soulscircuit/pilet/README.md

# pilet
this repository contains 3d files, pcb files, schematics, and documentation for pilet mini-computer. 
all files will be gradually released here. The schematics and pcbs are designed in kicad and released under CERN-OHL-P license. 

# current releases
- nvme module
