soulscircuit/pilet/nvme-module/README.md

#  License
The hardware design files for the Pilet PCB are licensed under the [CERN Open Hardware License v2 - Permissive (CERN-OHL-P-2.0)](https://ohwr.org/project/cernohl).

You are free to use, modify, manufacture, and sell the hardware, provided that:
- You include attribution to the original author Soulscircuit.com
- You include a copy of this license in your distribution
