soulscircuit/pilet/nvme-module/components/0518CDMCCDS-2R2MC/3D/0518CDMCCDS-2R2MC.stp

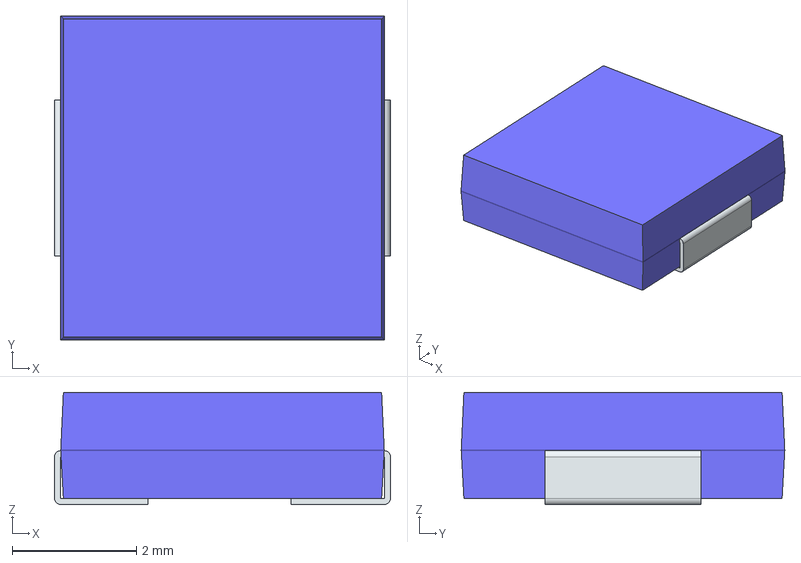
[picture p1: CAD file, 2025-11-07]
nvme-module/components/0518CDMCCDS-2R2MC/3D/0518CDMCCDS-2R2MC.stp
5.40 x 5.20 x 1.80 mm
FilletPin1
FilletPin2
