soulscircuit/pilet/nvme-module/components/687316124422/6873XX124422_687316124422.step

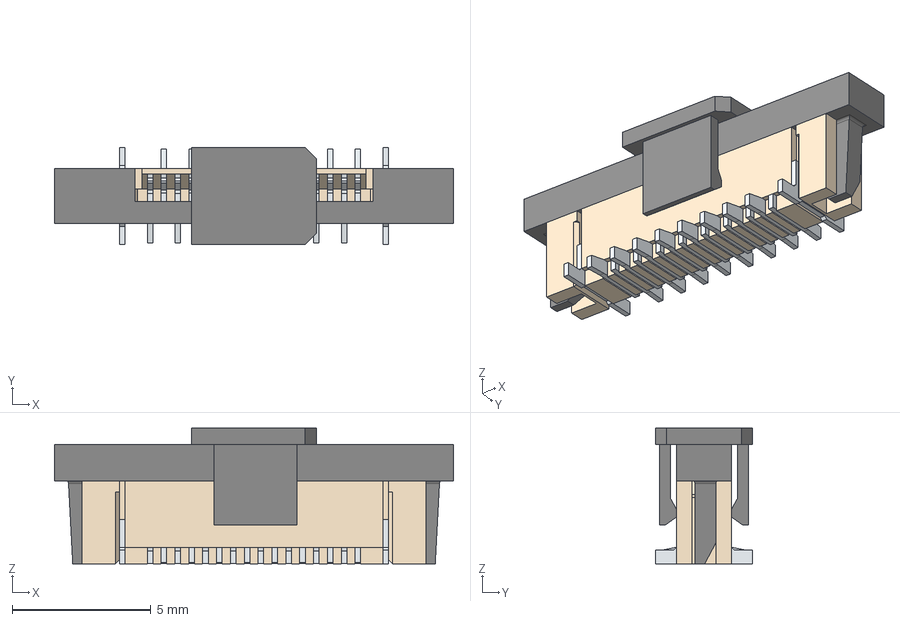
[picture p2: CAD file, 2025-11-07]
nvme-module/components/687316124422/6873XX124422_687316124422.step
14.4 x 3.50 x 4.90 mm
6873xx124422_PIN_COTE x 2
6873xx124422_PIN_A x 8
6873xx124422_PIN_B x 8
6873xx124422_Pick and Place
687316124422_CAP
