soulscircuit/pilet/nvme-module/components/ASEK-32.768KHZ-LRT/OSC-SMD_4P-L3.2-W2.5-BL-1.step

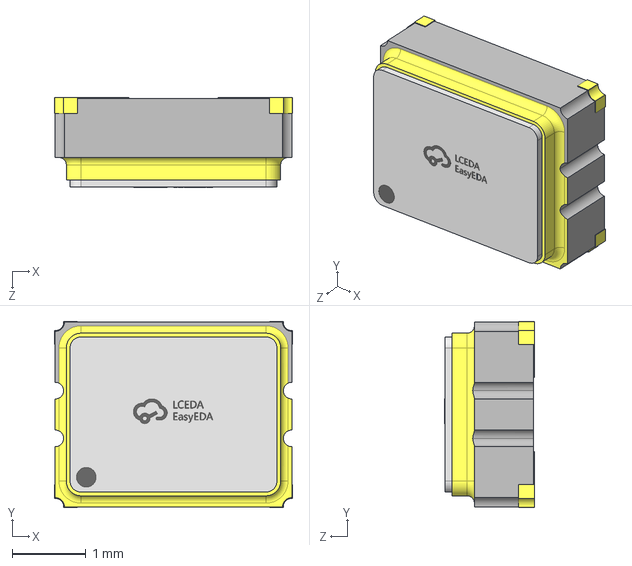
[picture p3: CAD file, 2025-11-07]
nvme-module/components/ASEK-32.768KHZ-LRT/OSC-SMD_4P-L3.2-W2.5-BL-1.step
3.22 x 2.52 x 1.21 mm
