soulscircuit/pilet/nvme-module/components/F31W-1A7H1-11016--3DModel-STEP-56544.STEP

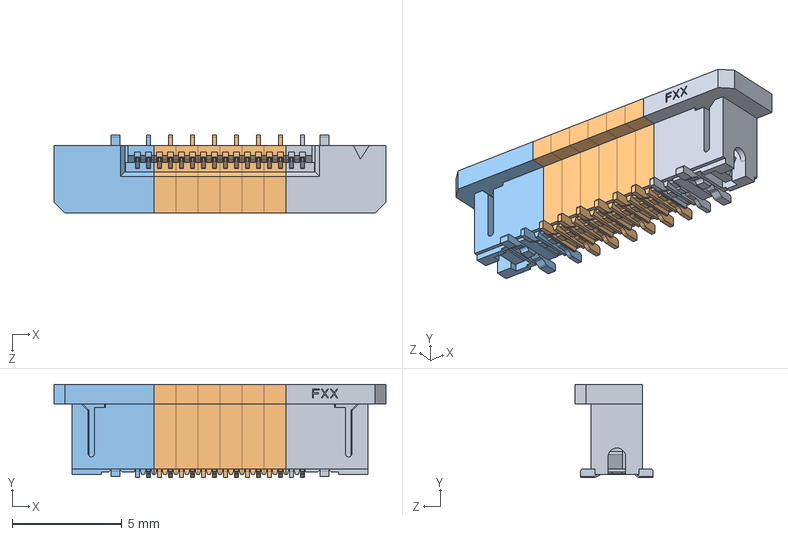
[picture p4: CAD file, 2025-11-07]
nvme-module/components/F31W-1A7H1-11016--3DModel-STEP-56544.STEP
15.1 x 4.25 x 3.57 mm
F314_336_31W_31Z_L.STEP
F314_336_31W_31Z_M.STEP x 6
F314_336_31W_31Z_R_EVEN.STEP
