soulscircuit/pilet/nvme-module/components/Inductor/0518CDMCCDS-2R2MC/IND-SMD_L5.4-W5.2-H1.6_0518CDMCCDS.step

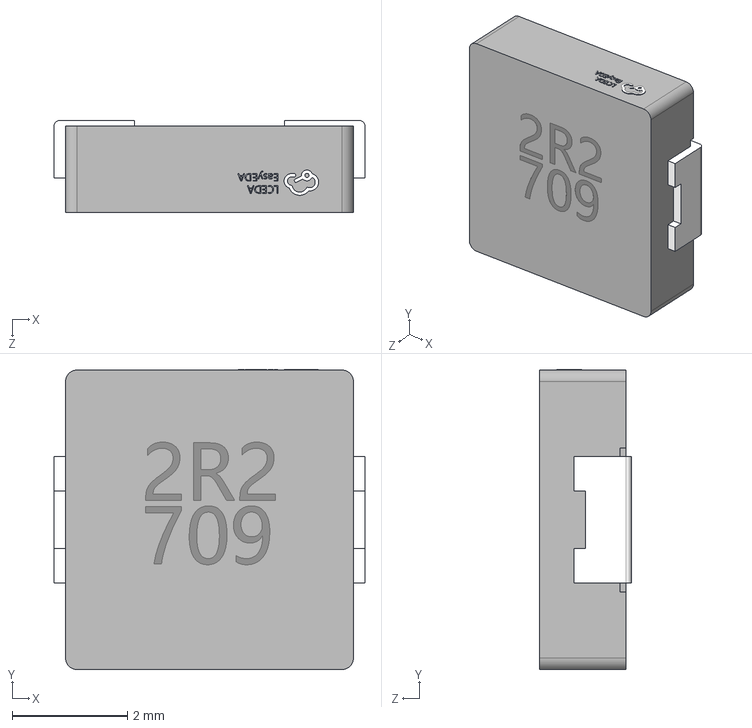
[picture p5: CAD file, 2025-11-07]
nvme-module/components/Inductor/0518CDMCCDS-2R2MC/IND-SMD_L5.4-W5.2-H1.6_0518CDMCCDS.step
5.40 x 5.21 x 1.60 mm
