soulscircuit/pilet/nvme-module/components/SRP4020TA-2R2M/SRP4020TA-2R2M.step

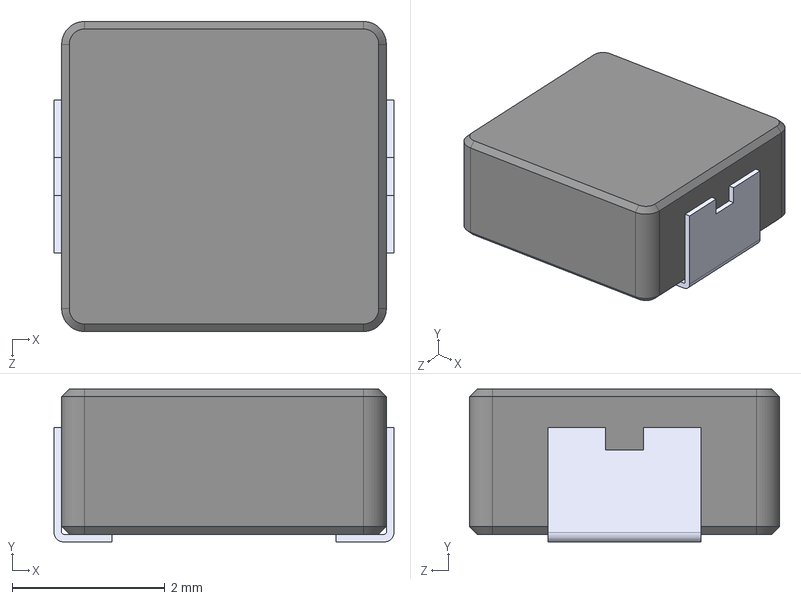
[picture p6: CAD file, 2025-11-07]
nvme-module/components/SRP4020TA-2R2M/SRP4020TA-2R2M.step
4.45 x 2.00 x 4.06 mm
