soulscircuit/pilet/nvme-module/components/stepfiles/Oscillator_ECS-3225S.STEP

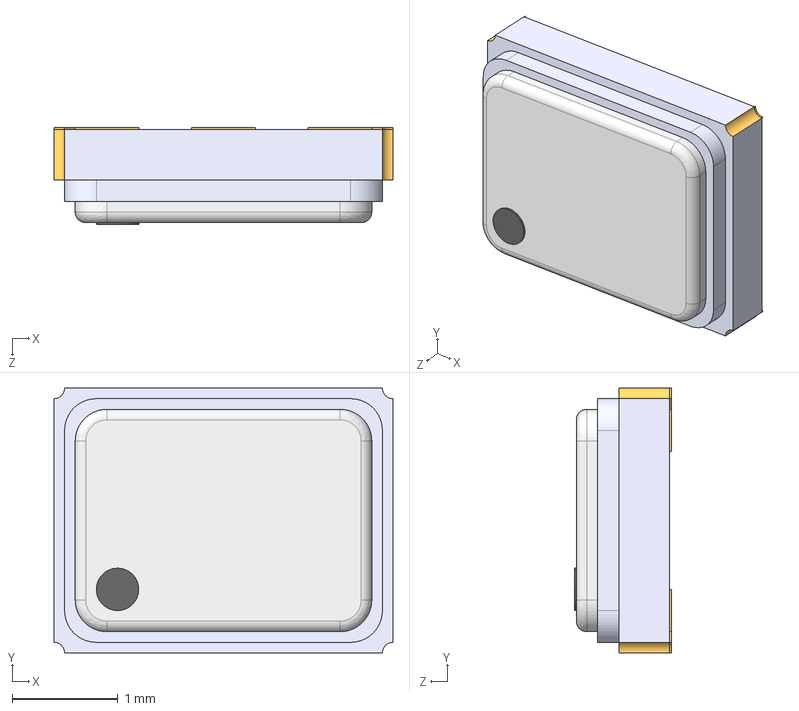
[picture p7: CAD file, 2025-11-07]
nvme-module/components/stepfiles/Oscillator_ECS-3225S.STEP
3.20 x 2.50 x 0.92 mm
User Library-Oscillator_ECS-3225S_MetalFrame
User Library-Oscillator_ECS-3225S_Pin1Marker
User Library-Oscillator_ECS-3225S_Pin5
User Library-Oscillator_ECS-3225S_Pin2
User Library-Oscillator_ECS-3225S_Pin1
User Library-Oscillator_ECS-3225S_Pin4
User Library-Oscillator_ECS-3225S_Lid
User Library-Oscillator_ECS-3225S_Pin6
User Library-Oscillator_ECS-3225S_Pin3
User Library-Oscillator_ECS-3225S_Ceramic
