soulscircuit/pilet/nvme-module/components/WA-SMSI_9774XXX151/WA-SMSI_9774XXX151.step

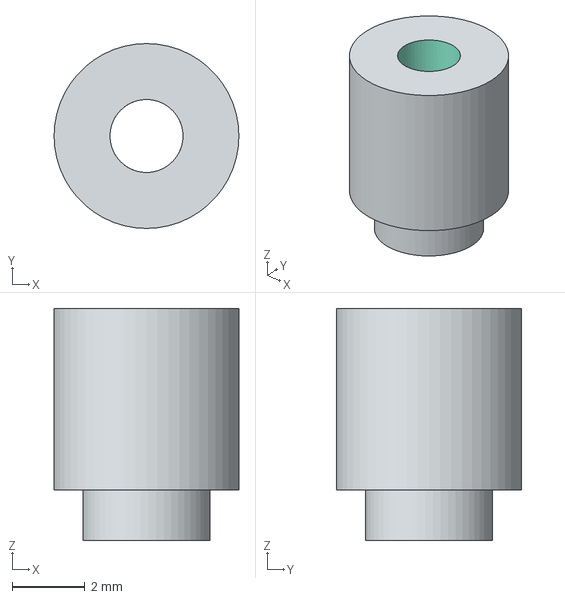
[picture p8: CAD file, 2025-11-07]
nvme-module/components/WA-SMSI_9774XXX151/WA-SMSI_9774XXX151.step
5.10 x 5.10 x 6.40 mm
