soulscircuit/pilet/nvme-module/components/BM02B-SURS-TF.STEP

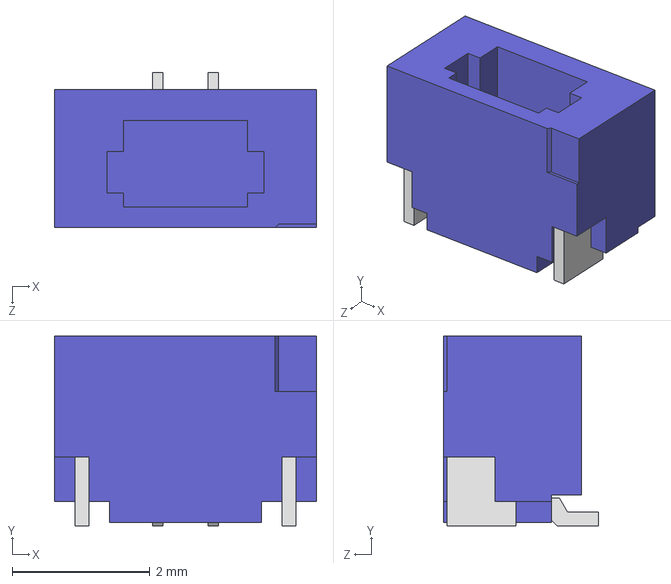
[picture p9: CAD file, 2025-11-07]
nvme-module/components/BM02B-SURS-TF.STEP
3.80 x 2.75 x 2.25 mm
