soulscircuit/pilet/nvme-module/components/stepfiles/DFN-8-1EP_2x2mm_P0.5mm_EP0.6x1.2mm.step

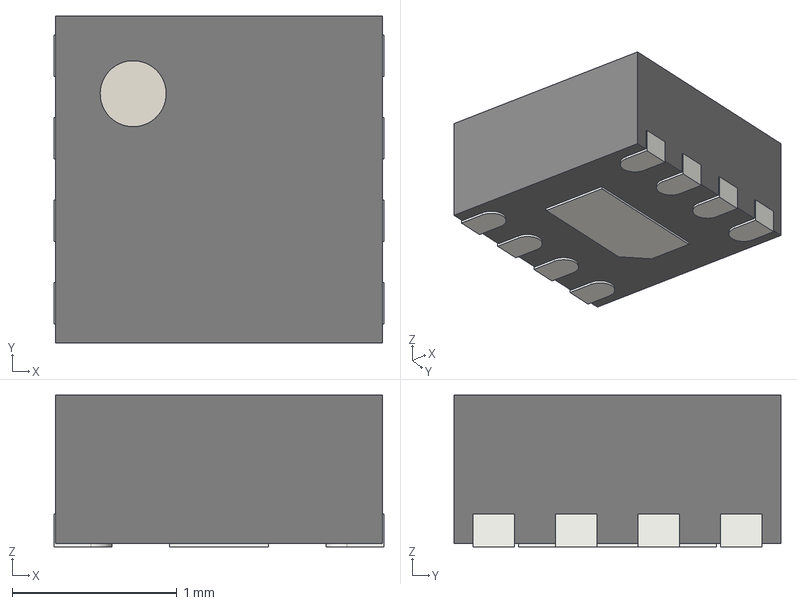
[picture p10: CAD file, 2025-11-07]
nvme-module/components/stepfiles/DFN-8-1EP_2x2mm_P0.5mm_EP0.6x1.2mm.step
2.00 x 1.98 x 0.92 mm
