soulscircuit/pilet/nvme-module/components/stepfiles/3225 SMD Crystal Oscillator.STEP

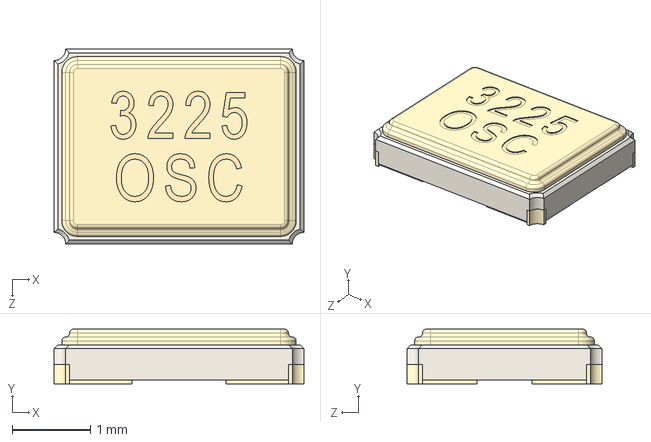
[picture p11: CAD file, 2025-11-07]
nvme-module/components/stepfiles/3225 SMD Crystal Oscillator.STEP
3.20 x 0.7 x 2.50 mm
