soulscircuit/pilet/nvme-module/components/stepfiles/SMTSOM330BTR.step

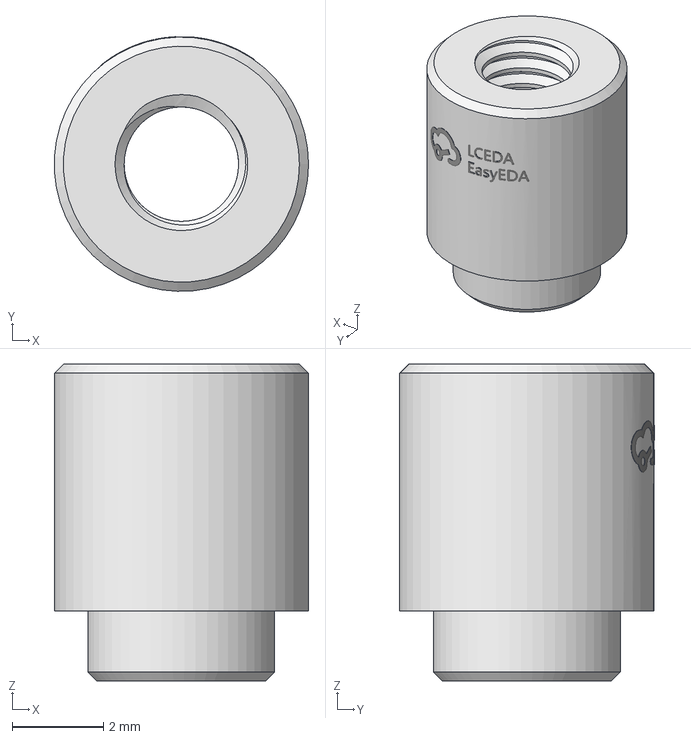
[picture p12: CAD file, 2025-11-07]
nvme-module/components/stepfiles/SMTSOM330BTR.step
5.55 x 5.57 x 6.93 mm
sCL9-Board
sCL9-CN1-M3-TH_BD6.0-D4.3
