soulscircuit/pilet/nvme-module/components/stepfiles/MTFDHBK1T0TDP-1AT12AIYY.stp

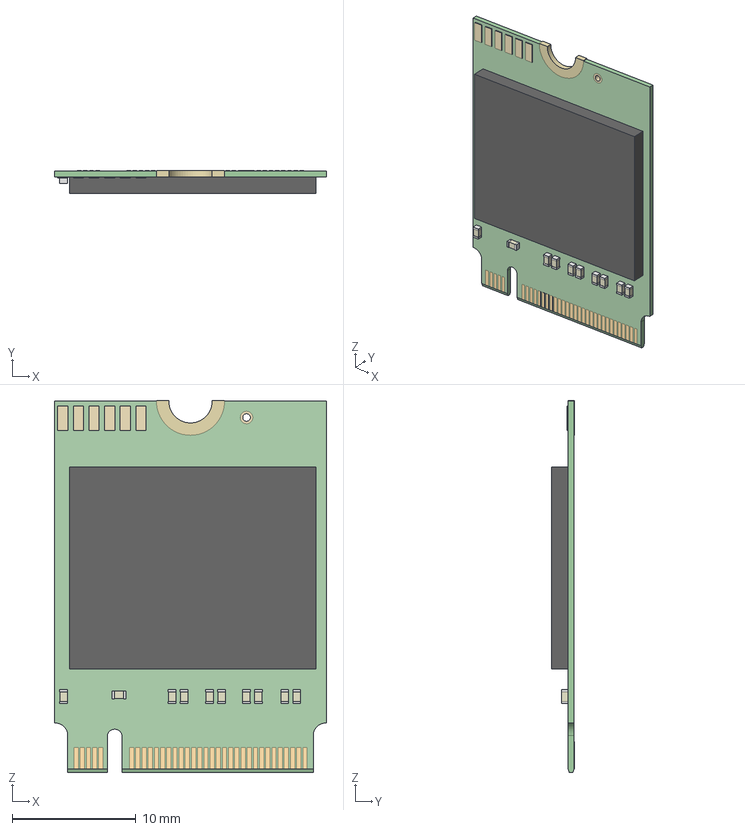
[picture p13: CAD file, 2025-11-07]
nvme-module/components/stepfiles/MTFDHBK1T0TDP-1AT12AIYY.stp
22.0 x 1.90 x 30.1 mm
