soulscircuit/pilet/nvme-module/components/stepfiles/SOT-523.STEP

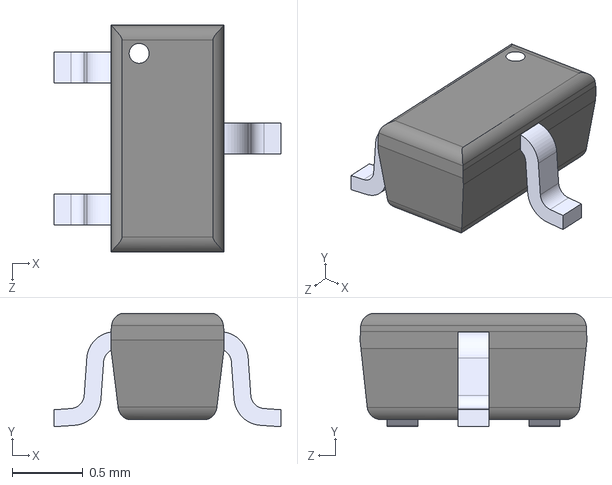
[picture p14: CAD file, 2025-11-07]
nvme-module/components/stepfiles/SOT-523.STEP
1.60 x 0.8 x 1.60 mm
