soulscircuit/pilet/nvme-module/components/stepfiles/SL0420-2R2M.step

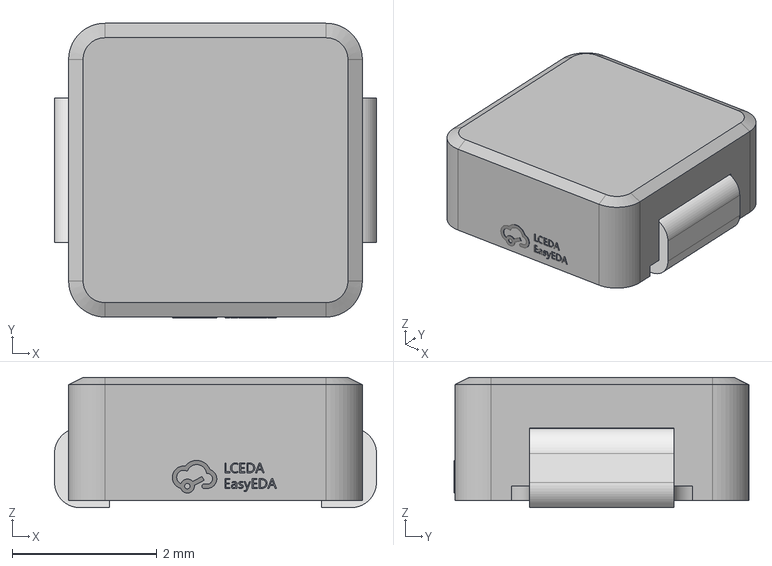
[picture p15: CAD file, 2025-11-07]
nvme-module/components/stepfiles/SL0420-2R2M.step
4.45 x 4.07 x 1.80 mm
eAmg-Board
