soulscircuit/pilet/nvme-module/nvme-module.kicad_pcb

## KiCad design nvme-module/nvme-module.kicad_pcb (2025-11-07)

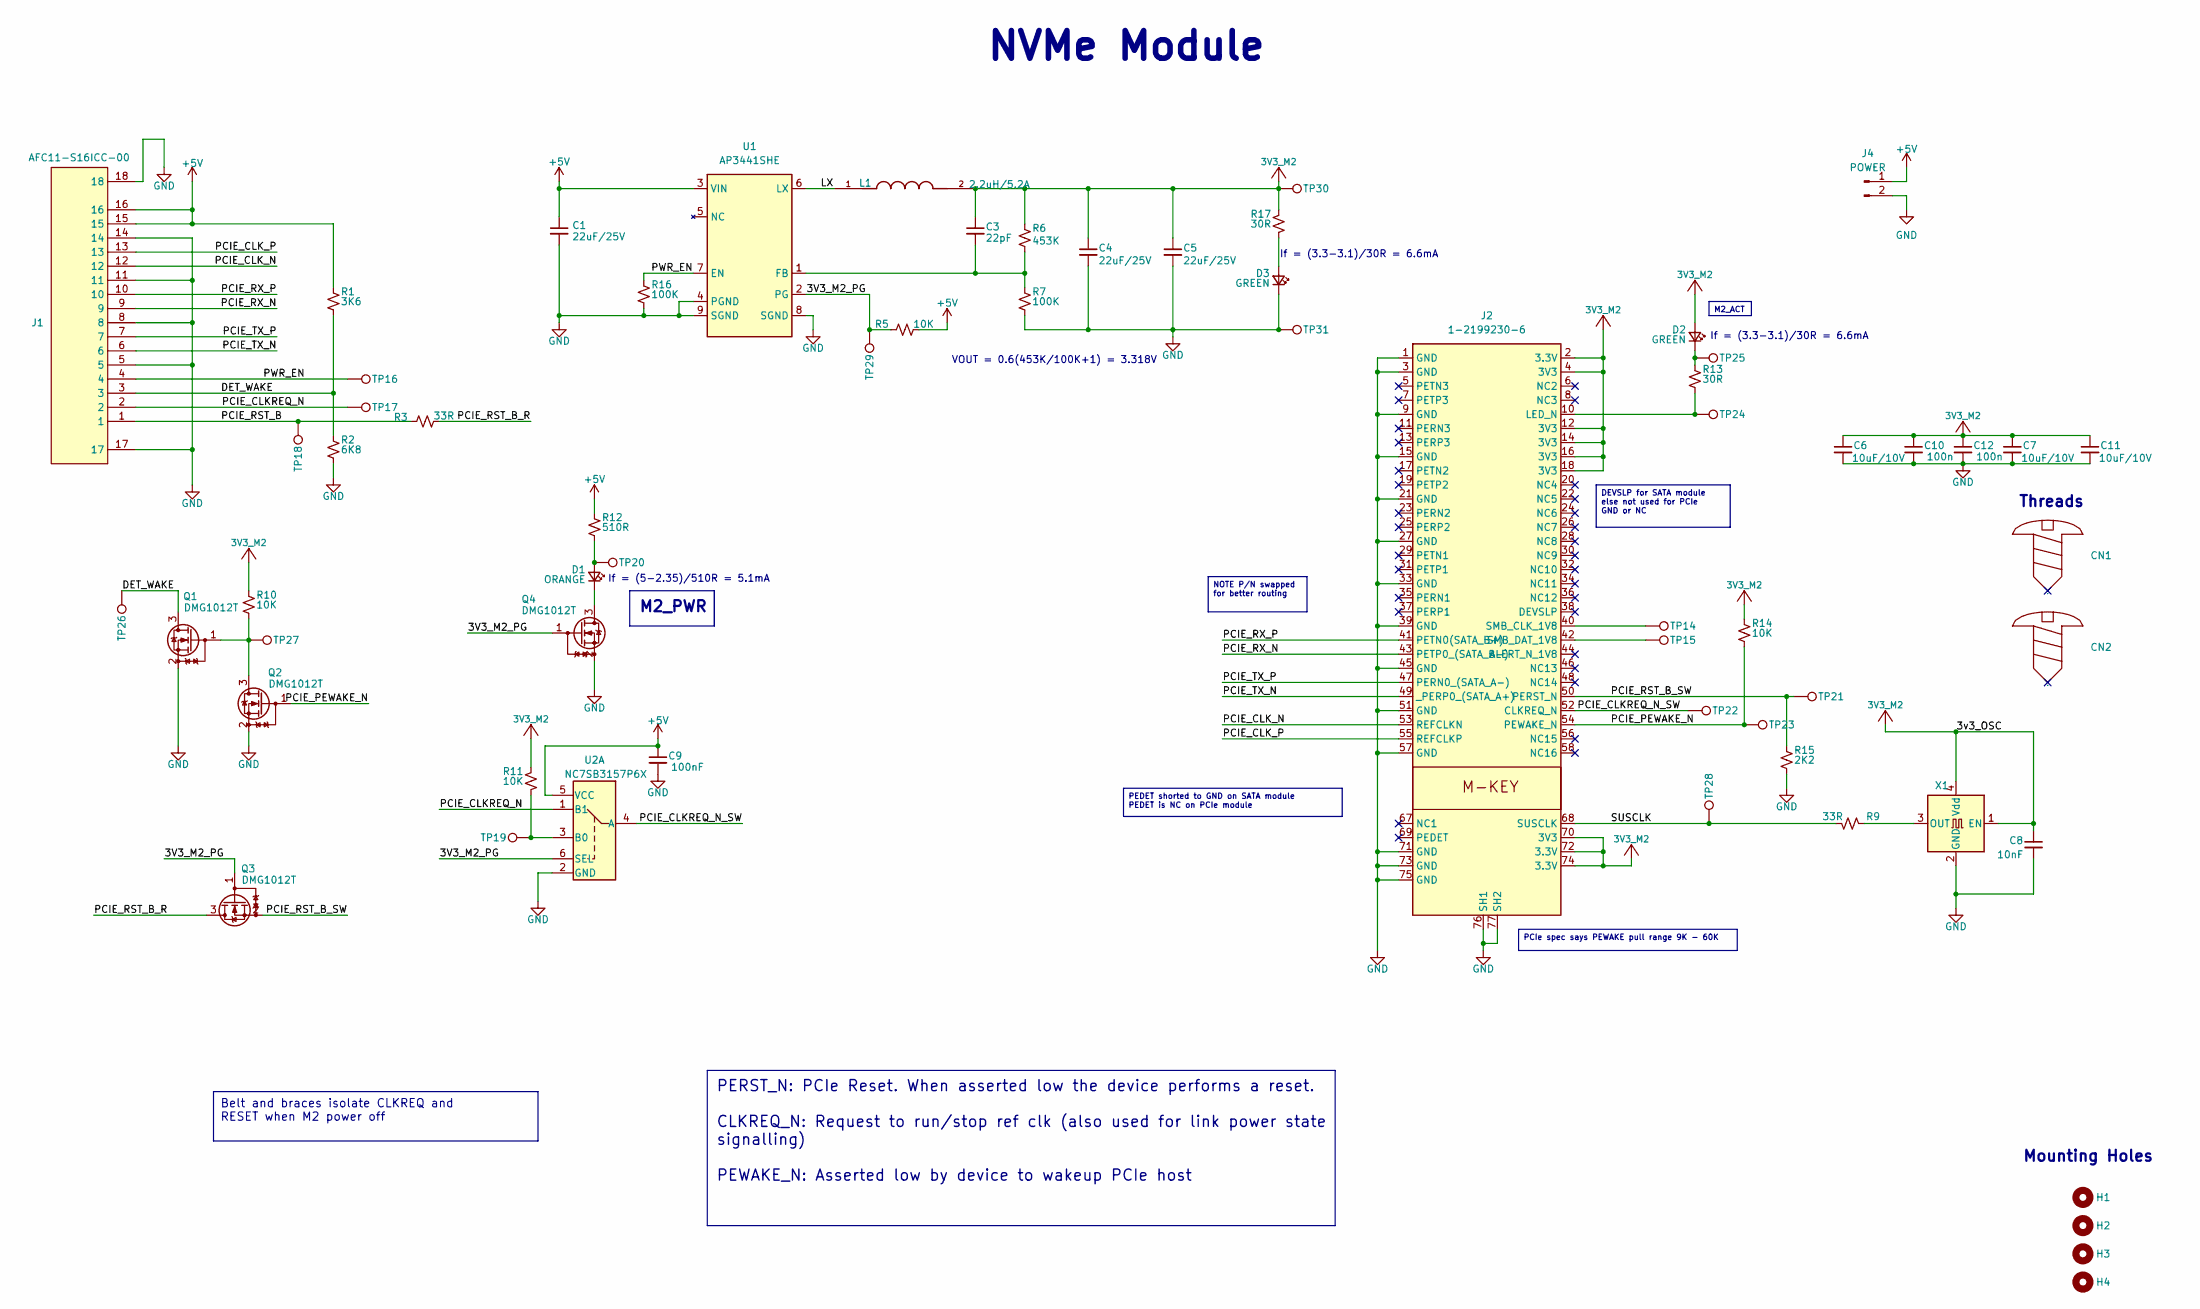
[picture p16: schematic nvme-module.kicad_sch, Pilet's nvme module]

Parts:
C1, C4, C5: 22uF/25V; C_0805_2012Metric; LCSC Part Number C45783
C3: 22pF; C_0603_1608Metric; LCSC Part Number C1653
C6, C7, C11: 10uF/10V; C_0603_1608Metric; LCSC Part Number C19702
C8: 10nF; C_0603_1608Metric; LCSC Part Number C57112
C9: 100nF; C_0603_1608Metric; LCSC Part Number C14663
C10, C12: 100n; C_0603_1608Metric; LCSC Part Number C14663
CN1, CN2: MountingHole_2mm
D1: ORANGE; LED_0603_1608Metric; LCSC Part Number C401119
D2, D3: GREEN; LED_0603_1608Metric; LCSC Part Number C12065
H1, H2, H3, H4: MountingHole; MountingHole_2.5mm_Pad_TopBottom
J1: AFC11-S16ICC-00; FPC-SMD_16P-L13.5-W2.0-P0.50; LCSC Part Number C11071
J2: 1-2199230-6; AMPHENOL_MDT320M03001; LCSC Part Number C4710843
J4: POWER; PinHeader_1x02_P2.54mm_Vertical; LCSC Part Number C124375
L1: 2.2uH/5.2A; IND-SMD_L5.4-W5.2_0518CDMCCDS; LCSC Part Number C212256
Q1, Q2, Q3, Q4: DMG1012T; SOT-523; LCSC Part Number C20512
R1: 3K6; R_0603_1608Metric; LCSC Part Number C22980
R2: 6K8; R_0603_1608Metric; LCSC Part Number C23212
R3, R9: 33R; R_0603_1608Metric; LCSC Part Number C23140
R5, R10, R11, R14: 10K; R_0603_1608Metric; LCSC Part Number C25804
R6: 453K; R_0603_1608Metric; LCSC Part Number C3013202
R7, R16: 100K; R_0603_1608Metric; LCSC Part Number C25803
R12: 510R; R_0603_1608Metric; LCSC Part Number C23193
R13, R17: 30R; R_0603_1608Metric; LCSC Part Number C22985
R15: 2K2; R_0603_1608Metric; LCSC Part Number C4190
TP14, TP15, TP16, TP17, TP18, TP19, TP20, TP21, TP22, TP23, TP24, TP25, TP26, TP27, TP28, TP29, TP30, TP31: TestPoint; TestPoint_Pad_D1.0mm
U1: AP3441SHE; DFN-8-1EP_2x2mm_P0.5mm_EP0.9x1.7mm; LCSC Part Number C2070918
U2: NC7SB3157P6X; SOT-363_SC-70-6; LCSC Part Number C20417168
X1: ASE-xxxMHz; OSC-SMD_4P-L3.2-W2.5-BL-1; LCSC Part Number C2650753

Connections:
3V3_M2: C3.1, C4.1, C5.1, C6.1, C7.1, C8.1, C10.1, C11.1, C12.1, D2.2 (A), J2.2 (3.3V), J2.4 (3V3), J2.12 (3V3), J2.14 (3V3), J2.16 (3V3), J2.18 (3V3), J2.70 (3V3), J2.72 (3.3V), J2.74 (3.3V), L1.2, R6.1, R10.1, R11.1, R14.1, R17.1, TP30.1, X1.1 (EN), X1.4 (Vdd)
+5V: C1.1, C9.1, J1.15, J1.16, J4.1, R1.1, R5.2, R12.1, U1.3 (VIN), U2.5 (VCC)
/3V3_M2_PG: Q3.1 (G), Q4.1 (G), R5.1, TP29.1, U1.2 (PG), U2.6 (SEL)
/ PCIE_CLKREQ_N_SW: J2.52 (CLKREQ_N), TP22.1, U2.4 (A)
/DET_WAKE: J1.3, Q1.3 (D), R1.2, R2.1, TP26.1
/LX: L1.1, U1.6 (LX)
/PCIE_CLKREQ_N: J1.2, TP17.1, U2.1 (B1)
/PCIE_CLK_N: J1.12, J2.53 (REFCLKN)
/PCIE_CLK_P: J1.13, J2.55 (REFCLKP)
/PCIE_PEWAKE_N: J2.54 (PEWAKE_N), Q2.1 (G), R14.2, TP23.1
/PCIE_RST_B: J1.1, R3.1, TP18.1
/PCIE_RST_B_R: Q3.3 (D), R3.2
/PCIE_RST_B_SW: J2.50 (PERST_N), Q3.2 (S), R15.1, TP21.1
/PCIE_RX_N: J1.9, J2.43 (PETP0_(SATA_B-))
/PCIE_RX_P: J1.10, J2.41 (PETN0(SATA_B+))
/PCIE_TX_N: J1.6, J2.49 (_PERP0_(SATA_A+))
/PCIE_TX_P: J1.7, J2.47 (PERN0_(SATA_A-))
/PWR_EN: J1.4, R16.1, TP16.1, U1.7 (EN)
/SUSCLK: J2.68 (SUSCLK), R9.2, TP28.1
GND: C1.2, C4.2, C5.2, C6.2, C7.2, C8.2, C9.2, C10.2, C11.2, C12.2, D3.1 (K), J1.5, J1.8, J1.11, J1.14, J1.17, J1.18, J2.1 (GND), J2.3 (GND), J2.9 (GND), J2.15 (GND), J2.21 (GND), J2.27 (GND), J2.33 (GND), J2.39 (GND), J2.45 (GND), J2.51 (GND), J2.57 (GND), J2.71 (GND), J2.73 (GND), J2.75 (GND), J2.76 (SH1), J2.77 (SH2), J4.2, Q1.2 (S), Q2.2 (S), Q4.2 (S), R2.2, R7.2, R15.2, R16.2, TP31.1, U1.4 (PGND), U1.8 (SGND), U1.9 (SGND), U2.2 (GND), X1.2 (GND)
unnamed: D1.2 (A), R12.2, TP20.1
unnamed: D1.1 (K), Q4.3 (D)
unnamed: D2.1 (K), R13.1, TP25.1
unnamed: D3.2 (A), R17.2
unnamed: J2.10 (LED_N), R13.2, TP24.1
unnamed: J2.40 (SMB_CLK_1V8), TP14.1
unnamed: J2.42 (SMB_DAT_1V8), TP15.1
unnamed: Q1.1 (G), Q2.3 (D), R10.2, TP27.1
unnamed: C3.2, R6.2, R7.1, U1.1 (FB)
unnamed: R11.2, TP19.1, U2.3 (B0)
unnamed: R9.1, X1.3 (OUT)

Notes on the sheet:
If = (3.3-3.1)/30R = 6.6mA
If = (5-2.35)/510R = 5.1mA
VOUT = 0.6(453K/100K+1) = 3.318V
Threads
NVMe Module
Mounting Holes
M2_ACT
PCIe spec says PEWAKE pull range 9K - 60K
M2_PWR
DEVSLP for SATA module else not used for PCIe GND or NC
PEDET shorted to GND on SATA module PEDET is NC on PCIe module
Belt and braces isolate CLKREQ and RESET when M2 power off
PERST_N: PCIe Reset. When asserted low the device performs a reset. CLKREQ_N: Request to run/stop ref clk (also used for link power state signalling) PEWAKE_N: Asserted low by device to wakeup PCIe host
NOTE P/N swapped for better routing

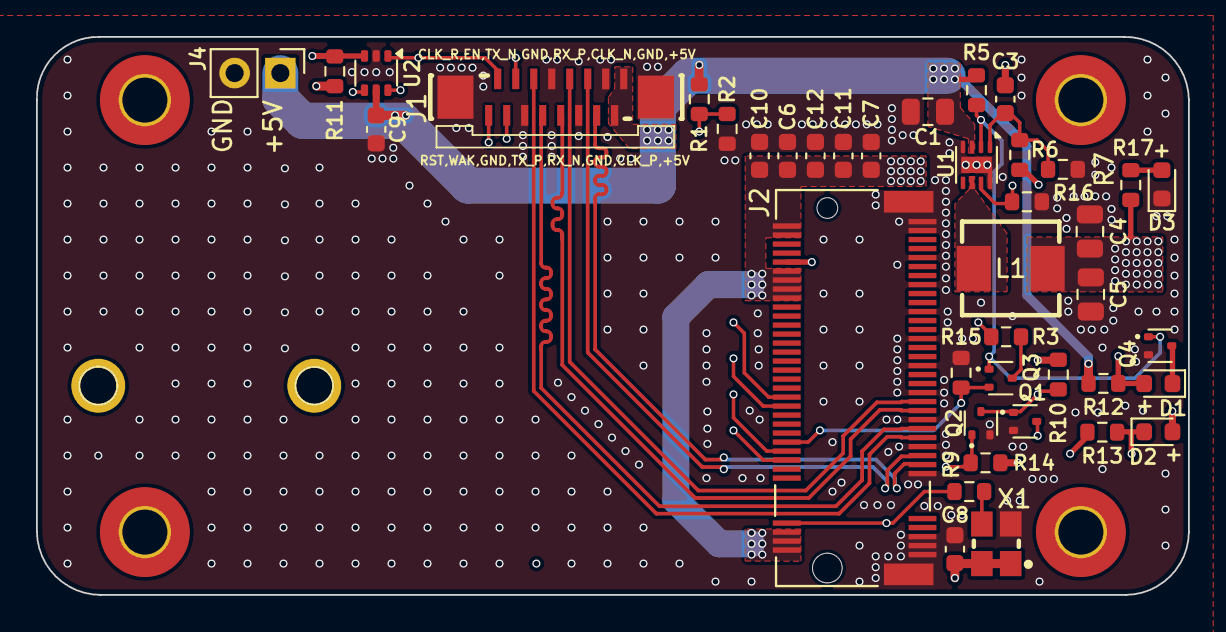
[picture p17: board nvme-module.kicad_pcb from above]

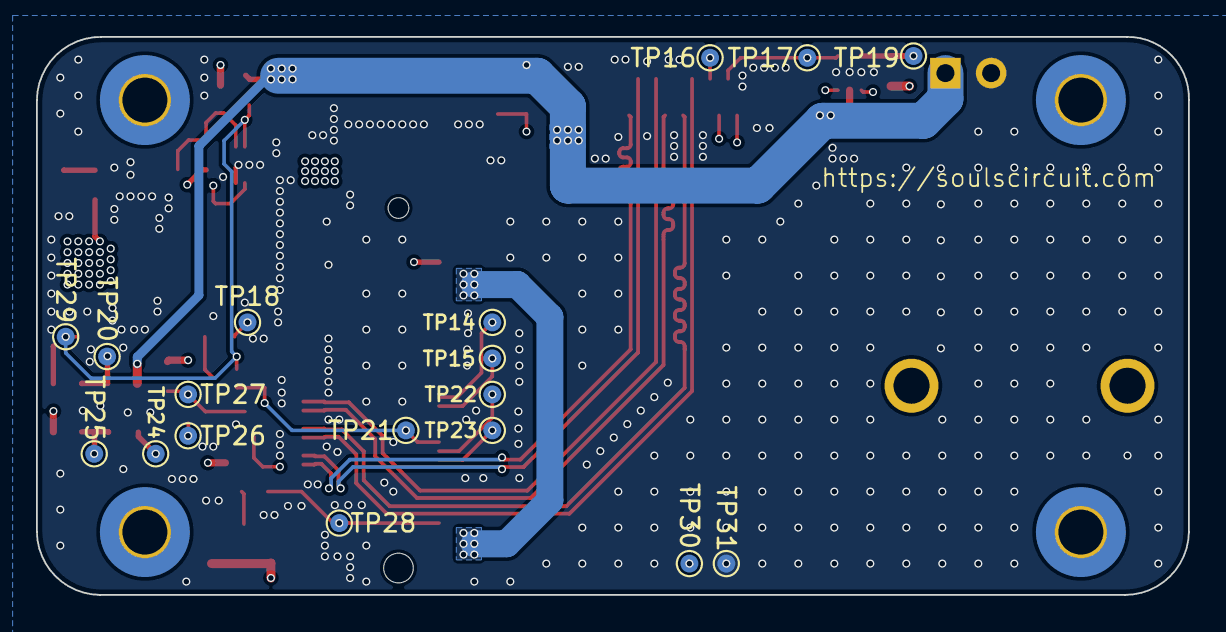
[picture p18: board nvme-module.kicad_pcb from below]

Board: 4 copper layers, 64.0 x 31.0 mm, 64 parts (18 on the bottom side), 31 nets.
