soulscircuit/pilet/(threads)

Thread 1 (2025-09-18):

Vaporware

pixelkarma, 2025-09-18:
How's about you put some stuff on here so we know you're actually working on it and not just spending out million bucks on yourself? You said it was gonna have open source everything, so put the case models up. Some pcbs. Like literally anything.

RyzenOne20, 2025-09-20:
Your point being, your are harping down on the idea that you deserve the project files when they are not done yet, and you clearly didn't read the campaign. Honest question, how would you feel if you paid for a product months before release and then the company decided after your spent 500 bucks that it is now open source and now people can build it significantly cheaper. and you basically wasted that 500 bucks. Would you be upset or not?

Compared to what Pilet is doing where the backers get what they paid for and then the rest of there community can now build it at there own time.

Yes i do agree that it has been a while and and still no time and date on when it goes open source for us, but as any project goes it wont be instant.

lookatthisdoode, 2025-09-22:
> Nevertheless, there is no total silence
Yeah my apologies, have not seen this one. But usually I search 'pilet' quite often because I am actually excited about it, and not much info as I would like there to be.
